yoavjavits/VoicceControl/RubiksCubeFirmware_Arduino_Mega/Readme.md

# Commands to send for robot using UART from ESP32
