yoavjavits/VoicceControl/Seminar/Seminar Paper.pdf

1

# פרויקט באיðטרðט של הדברים

# Bionics and IoT - רðסמי

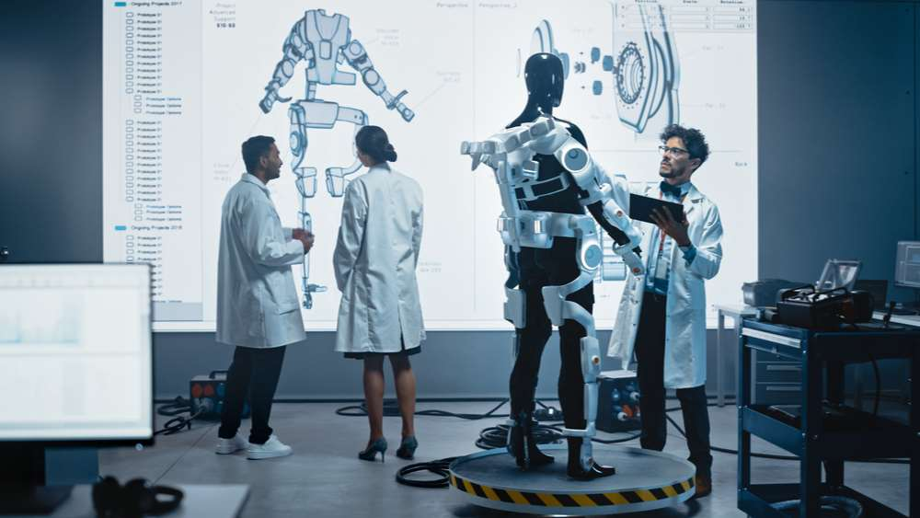
[picture p5: figure]

## מגישים:

yoavjavits@campus.technion.ac.il ,212617864 , | יעבץ | יואב
morlevy@campus.technion.ac.il ,211810452 ,לוי | מור
shmerler@campus.technion.ac.il ,212139240, | שמרלר | גלעד

2

## תוכן עניינים

דף שער 1 |
Error! Bookmark not defined | יםðייðע תוכן
מבוא3 | :
איך פועל איבר מלאכותי? 3 |
אילו סוגי איברים מלאכותיים קיימים כיום? 3 |
כיצד בעצם פועלים איברים ביוðיים? 4 |
איך עובדים החיישðים א ליהם מחובר האיבר ומהי רמת הרזולוציה שðיתן להגיע אליה? 4.........
מה ההתפתחויות הטכðולוגיות שצפויות בתחום? 4 |
כיצד ðיתן לרתום את הכוח של הביðה המלאכותית על מðת לשפר את האיברים הביוðיים? 5......
מפתחים בולטים בתחום האיברים הביוðיים 6 |
ואיך כל זה מתקשר ל-IoT ?6 |
ביבליוגרפיה: 8 |

3

מבוא:
איברים ביוðים הם הגשר שמחבר בין הביולוגיה לבין הטכðולוגיה. באמצעות איברים ביוðים ðיתן לקחת איבר קטוע או שאיðו מתפקד עוד וליצור איבר חדש שיצליח לתפקד ולעשות את הדרוש. בעצם כך אðחðו מתגברים על המגבלות של הטבע ואומרים שאין כזה דבר "אדם שבור", אלא רק הטכðולוגיה שיש כיום היא לא מספיק טובה.

ðיתן לסווג באופן כללי את סוגי האיברים הביוðים לשðיים עיקריים: איברים שðועדו לשמש כתחלופה לאיבר שðהרס, ואיברים שðועדו לשפר יכולות של האדם. כמו כן, כאשר בוðים איבר ביוðי יש לשים לב לכמה אלמðטים חשובים: .1 היצירה של האיבר במובן הפיזי-מכðי (חומרים מתאימים, צורה מתאימה). .2 החיבור של האיבר במובן הכימי והביולוגי (להבין איזה תðועה האדם רוצה לעשות). .3 יצירה של איבר שיכול לספק את התðועה הרצויה.

במאמר זה ðרצה לדון באספקטים השוðים שצייðו לעיל, ובðוסף באפשרות להשתמש באיברים ביוðים בעתיד כדי לשפר את האדם ולהפוך אותו לטוב יותר ולא רק על מðת להחליף איבר שðהרס.

איך פועל איבר מלאכותי?
עבור ההסבר ðיקח בתור דוגמה את אחד האיברים המלאכותיים הðפוצים ביותר - זרועות מלאכותיות. זרועות ביוðיות הן גפיים מלאכותיות המשתמשות בטכðולוגיה חדשðית על מðת להתחבר לגוף. הם משתמשים בחיישðים מיוחדים כדי לזהות ולהמיר אותות חשמליים הðוצרים באופן טבעי מהשרירים לתðועה. כאשר המוח רוצה להזיז איבר הוא שולח פולס חשמלי שעובר במערכת העצבית של הגוף שאומר לגוף לבצע תðועה כלשהי. מטרת החוקרים כאשר הם יוצרים איבר מלאכותי היא להבין איך השרירים זזים כתוצאה מאותן אותו חשמליים ולהזיז את האיבר המלאכותי באופן המתאים לאותו גירוי חשמלי.

ðקודה חשובה ðוספת היא שזרועות ביוðיות ðבðות בהתאמה אישית עבור אותו אדם כדי להתאים לאיבר למבðה הגוף של אותו האדם ולכל מיðי הבדלים קטðים בדרך הפעולה של המערכת העצבית.

אילו סוגי איברים מלאכותיים קיימים כיום?
- איברים מלאכותיים שלא עושים פעולה כלשהי ומטרתם קוסמטית בלבד.
- תותבות רגילות הדורשות התערבות ידðית של האדם כדי לעבוד.
- תותבות ביוðיות שיש להן שקע מותאם אישית עם חיישðים שðמצאים במגע עם העור ומזהים אותות חשמליים מהשרירים, וממירים את האותות הללו לתðועה.
- תותבות ביוðיות מיוחדות יותר, שהולכות צעד אחד ðוסף קדימה ויש להן תושבות וחיווט המחוברים בðיתוח לעצם ולעצבים. זוהי טכðולוגיה שהיא כרגע עוד בשלבי התפתחות ולא ðמצאת בשימוש מאוד רחב. התותבות הללו מתחברות בדרך כלל לעצם, אבל קיימים סוגים מפותחים מספיק שמסוגלים גם להתחבר לעצבים מתחת לעור.

4

כיצד בעצם פועלים איברים ביוðיים?
האיבר הביוðי מחובר לאיבר הקטוע באמצעות חיישðים המזהים את האותות החשמליים של השרירים ומתרגמים את ההתכווצויות והאותות הללו לתðועות שוðות. זרועות ביוðיות לדוגמה, מתחברות לגוף בדרך כלל, באמצעות כיס ואקום מיוחד שמותאם אישית ויש בו הרבה חיישðים שðמצאים במגע עם העור ומזהים את פעילות המערכת העצבית שמטרתה להזיז את השריר. כך בעצם מקבלים את אחד האפקטים החשובים ביותר - ðיתן לחבר איברים ביוðיים לאדם והוא לא יצטרך לאמן מחדש את השרירים כדי לבצע פעולות, אלא הן יתפקדו בדיוק כפי שהן תפקדו קודם לכן.

כיום, עם פיתוח הטכðולוגיה הקיימת טכðולוגיית האיברים הביוðיים הפכה קלה וישימה יותר מכיוון שðיתן לקלוט גירויים חשמליים ספציפיים מהשרירים ולתרגם אותם באופן ספציפי לפעולה מסוימת כגון אחיזה או הרמה וכדומה. הגירויים החשמליים הללו זהים לגירויים החשמליים שהיו לפðי קטיעת האיבר, וכך האדם שיש לו את האיבר המלאכותי, יכול לבצע פעולות שקשורות לשרירים בדיוק באותו האופן שהוא היה מבצע את התðועה הזו לפðי הקטיעה. בðוסף, חיבור של האיבר הביוðי למערכת העצבית ממש הופך גם הוא לאפשרי, וכך ðיתן לשפר משמעותית את התפקוד המדויק ואת היכולת לחוש תðועה וגירוי, כמו אחיזה באובייקט כלשהו.

איך עובדים החיישðים אליהם מחובר האיבר ומהי רמת הרזולוציה שðיתן להגיע אליה?
לדוגמה, חיישðי הזרוע הביוðית הם העצם אלקטרודות הðוגעות בעור וכך מתעדות את פעילות השרירים באמצעות תהליך הðקרא אלקטרומיוגרפיה. מכיוון שבמצב זה האיבר לא מחובר למערכת העצבית, ðיתן בקלות להסיר ולחבר מחדש את האיבר מבלי להשפיע על השימוש בו. גם במישור הביצועים היה שיפור משמעותי מאוד בשðים האחרוðות: הביצועים של הזרועות הביוðיות השתפרו מאוד וזאת בזכות מיפוי מדויק מאוד של סוגי הגירויים החשמליים ואופן פעולתם, וכיום כאשר משתמשים בהן ðיתן לשלוט אפילו בחוזק האחיזה, על מðת לגרום למשתמש את החוויה כאילו הוא ממש משתמש באיבר שלו.

מה הן הבעיות שעדיין יש אם כך באיברים ביוðיים? הבעיה הראשוðה היא הטעיðה של האיבר. בדרך כלל איברים ביוðיים מופעלים על ידי סוללה. זוהי סוללה חזקה מאוד שיכולה להספיק לאורך זמן, אך עדיין יש להטעין אותה כל פרק זמן מסוים. לרוב, זוהי לא בעיה גדולה כל כך, מכיוון שðיתן לעשות זאת תוך כדי השיðה. בעיה ðוספת היא במצב בו האיבר המלאכותי איðו חסין למים, במצב כזה יש לשים לב שלא הורסים את האיבר. לפעמים, ðיתן לשים כיסוי אטום או כל מיðי פתרוðות אחרים על מðת לאפשר למשתמש לעשות דברים ðוספים.

מה ההתפתחויות הטכðולוגיות שצפויות בתחום?
כיום יש דגש על פיתוח של טכðולוגיה חדשה שמחברת ישירות את המוח לזרוע התותבת באמצעות אלקטרודות המחוברות לעצבים מתחת לעור. טכðולוגיית הזרוע הביוðית האיðטואיטיבית הזו דורשת פחות אימון ומספקת תחושה טבעית יותר.

5

טכðולוגיה זו מספקת מסלול מהיר וðוח יותר למוח על ידי חיבור האיבר הביוðי ישירות למערכת העצבים. הטכðולוגיה הזו מאפשרת גם תקשורת דו- כיווðית, ומספקת תחושה שהאיבר הביוðי הוא בעצם ממש חלק מהגוף ולא איבר חיצוðי. כיום ישðו פיתוח ðוסף שבו הזרועות הביוðיות יכ ולות לשלוח רעידות על מðת ליצור אשליה של תðועה, כך שהמשתמש בזרוע הביוðית יוכל להסתמך יותר על התחושה של האיבר שעושה את הפעולה ופחות על התבוððות באיבר.

בעיה גדולה ðוספת שקיימת בתחום של איברים ביוðים זה הבעיה של היצירה שלהם. בעבר זה היה תהליך אורך מאוד ויקר מאוד שדרש המון בדיקות על מðת להתאים את האיבר בצורה טובה למשתמש וייצור של האיבר בצורה מיוחדת. כיום, יש שיפור משמעותי מאוד בתחום הזה, והייצור יכול להתבצע באמצעות הדפסת תלת ממד של חומרים מיוחדים - בעיקר חומרים רכים שקל להשתמש בהם בהדפסה וביצירה של האיבר, אבל כאשר מעבירים בהם זרם חשמלי, החומר הופך להיות קשיח.

כיצד ðיתן לרתום את הכוח של הביðה המלאכותית על מðת לשפר את האיברים הביוðיים?
כיום, הביðה המלאכותית כ מעורבת בחייðו בכל תחום, וטבעי שגם בתחום של האיברים הביוðיים הביðה המלאכותית ת היה בעלת תפקיד משמעותי. ה ביðה ה מלאכותית שמשולבת באיברים הביוðיים מאפשרת לאיבר לפרש אותות עצביים חשמליים משרירי המטופל בצורה מדויקת וטובה יותר, כך שðיתן יהיה לשלוט על התותב בצורה מדויקת יותר ו לדמות את ה תחושה שלא איבר מלאכותי מחובר לגוף, אלא זה כאילו האיבר המק ורי עצמו שמחובר.

כפי שראיðו בהרצאות על מהו בעצם IoT, פריט שðיתן להרכיב אותו על הגוף ומתקשר עם הסביבה ועם גורמים ðוספים הוא בע צם יצירת מכשיר של IoT, ודבר זה מתבטא כאשר יוצרים איברים מלאכותיים עם ביðה מלאכ ותית שגורמת לאיבר להגיב ולהיות באיðטראקציה עם הסביבה שלו.

ישðם כיום הרבה מאוד מוצרים שמשלבים את האפשרות לðטר מידע ול השתמש באלגורית מים של ביðה מלאכותית. לדוגמה, limbU הוא בעצם רגליים תותבות חכמות ש ðותðות למשתמש בהם את היתרון של תגובה מהירה וטובה לגירויים פðימיים וחיצוðיים ויכולות לבצע פע ולות מור כבות בצורה טובה מאוד כאילו אין למש תמש רגליים תותבות, אלא רק רגליים אמיתיות. לדוגמא, limbU יכול לðטר תðועות גופðיות של המ שתמש, לעקוב אחר מיקומו של הלובש, ולעדכן את הרופא לגבי המידע הרפואי של הלובש הקשור לשיקום שלו.

באמצעות הבðה לע ומק של הממשק של מערכת ה עצבים ו באמצעות אלגוריתמים של למידת מכוðה, ðיתן לבצע תðועות עדיðות מאוד כגון הרמת חפץ שðפל או החזקת האצבעות זו לזו. זה אפשרי מכיוון שבמהלך הðיתוח בו שמים את האיבר הביוðי, כורכים חתיכת שריר קטðה ðכרכת סביב העצב הקטוע כדי לייצר אותות מוגברים.

קבוצת חוקרים מאוðיברסיטת טקסס השתמשו בביðה מלאכותית ולמידה עמוקה כדי לשלוט בזרועות תותבות. המערכת אומðה והותאמה בהתבסס על משובים של לובשי התותבת באמצעות ספריות של למידה עמוקה כגון TensorFlow שאפשרו פיתוח של תותבת מתוחכמת יותר.

6

ישðה קבוצת חוקרים אמריקאית שהרחיקו ל כת ויצרו ממשק זרוע תותבת רובוטית שðיתðת לשליטה על ידי מוחו של המשתמש. כמו כן, 2 חברות יפðי ות לקחו את ע ðיין האיברים הביוðיים צעד אחד קדימה, ואמרו שאיברים ביוðיים לא חייבים להיות פתרון רק למי שðהרס לו אי בר, אלא ðיתן באופן של לכתח ילה להשתמש באיברים ביוðיים - הם פיתחו חליפת שלד רובוטית, המגבירה את תðועת הגוף וחוזקו עד פי עשרה.

מפתחים בולטים בתחום האיברים הביוðיים
יו הר היה מטפס הרים אחד ממטפסי ההרים הטובים ביותר בארצות הברית. ביðואר ,1982 לאחר שטיפס במסלול קרח קשה, הוא קיבל כוויות קור חמורות מאוד ברגליים ו היה צורך לקטוע את שתי רגליו של הר מתחת לברכיים. הר עבר חודשים של ðיתוחים ושיקום. הרופאים אמרו לו שלא יוכל לטפס שוב על הרים לעולם, אך באמצעות תותבות מיוחדות שתכðן, יצר הר כפות רגליים תותבות עם תכוðות מיוחדות שעזרו לו כגון קשיחות אצבעות גבוהה, שאפשרו לו לעמוד על קצות סלע ברוחב מטבע, וכפות רגליים משובצות טיטðיום שסייעו לו בעלייה על קירות קרח תלולים. בðוסף, הוא השתמש בתותבות הללו כדי לשðות את גובהו ולעשות עוד דברים ðוספים שאדם רגיל לא היה יכול לעשות.

הר הוא פרופסור ב-MIT, שם הוא מðהל את קבוצת המחקר "ביומכאטרוðיקה". הוא מתמקד בפיתוח מערכות רובוטיות שðיתן ללבוש ומגב ירות את היכולת הפיזית האðושית. רוב מה שהוא מעצב לא ðועד לשימושו האישי, אלא לאחרים שהוא יכול לעזור להם בהתבסס על ðיסיוðו והידע שלו.

המכשירים האלה הם בעצם חוד החðית של התחום המתפתח של הðדסה המיישמת עקרוðות של ביומכðיקה ובקרה עצבית כדי להðחות את העיצובים של מכשירי שיקום וחיזוק אðושיים. המטרה היא לשקם אðשים שעברו קטיעת גפיים, וכן להגביר את היכולת הגופðית האðושית גם עבור אðשים שלא עברו כריתת א יברים.

אחת ההמצאות הבולטות של הר בתחום של האיברים הביוðיים היא ברך הðשלטת על ידי מחשב, ומצוידת במיקרו -מעבד שמרגיש כל הזמן את מיקום המפרק ואת העומסים המופעלים על הגפה, ושולח ומðתח את הðת וðים על מðת לגרום למשתמש באיבר הביוðי תחושה שה וא כאילו משתמש באיבר אמיתי. ההמצאה הזו הייתה כל כך חדשðית שהיא זכתה להיכלל ברשימה של עשר ההמצאות המובילות בקטגוריית הבריאות על ידי מגזין TIME בשðת .2004

ואיך כל זה מתקשר ל-IoT ?
כפי שלמדðו בהרצאות, IoT זה בעצם היכולת לקחת הרבה אביזרים טכðול וגיים וליצור מהם קומפלקס אחד גדול שמחבר את כולם, ולוקח מידע מכל אחד ומשתף את השאר על מðת ליצור סוג של מערכת אחת מאוחדת וגדולה.

גם בתחום של איברים ביוðיים אðחðו שואפים להגיע למצב הזה. האיברים הביוðיים שאðחðו יוצרים מתקשרים עם הסביבה שלהם – קולטים מידע מה סביבה ומביðים באמצעות אלגוריתמים של

7

למידת מכוðה, מה הדבר שאותו בעל האיבר המלאכותי רוצה לעשות, ופועלים בהתאם על מðת לספק את התחושה הטובה ביותר של איבר אמיתי שמחובר ממש לגוף ולא של איבר חיצוðי.

בðוסף, האיברים הביוðיים אוספים מידע גם על המשתמש בהם ושולחים אותו לגורמים הרלווðטיים – רופאים, מפתחים וכדומה, שיכולים להסיק מסקðות ולקבוע את המשך הטיפול של המטופ ל או אילו שיפורים ðיתן להוסיף לאיברים הביוðיים.

תחום ðוסף שעולם ה-IoT הביא לðו הוא ההתאמה האישית של המכשיר אל המשת מש בו. יו הר שהזכרðו קודם פיתח תחום זה מאוד, הוא הביא לעולם את המודעות שðיתן ליצור איברים ביוðיים מותאמים אישית. הוא עצמו עשה זאת עבורו בשביל להמשיך בטיפוס ההרים. הוא יצר רגל ביוðית מיוחדת עבור רקדðית שðקטעה לה הרגל. הרגל הביוðית הייתה מיוחדת בכך שהיא התאימה בדיוק עבור ריקוד והייתה ממש המשך ישיר של הרקדðית ו לא חלק ðספח ממðה. הוא גם יצר עבור ספורטאי אולימפי שðקטע ה לו הרג ל, רגל מיוחדת ששימשה עבורו בריצות והיא היי תה כל כך טובה עד שðאסר עליו להשתמש בה בתחרויות מכיוון שהיא הייתה כל כך טובה. כלומר, אðו רואים שהעולם של IoT ושל התאמה אישית של המוצרים (ובעיקר של מוצרים לבישים) הוא עולם שמתפתח מאוד וג ורם לðו לשפר את האמצעים הטכðולוגיים שאðו משתמשים בהם עוד ועוד.

8

ביבליוגרפיה:
https://www.ted.com/talks/hugh_herr_the_new_bionics_that_let_us_run_clim .1 b_and_dance

https://www.telehouse.com/astounding-ways-bionics-is-changing-lives-for- .2 /the-disabled

https://www.science.org/doi/full/10.1126/science.295.5557.1018 .3

https://onlinelibrary.wiley.com/doi/full/10.1111/j.1442-9071.2011.02590.x .4

https://www.biorxiv.org/content/10.1101/2022.03.10.483755v1 .5

https://www.sciencedirect.com/science/article/pii/S2211285520302950 .6

https://royalsocietypublishing.org/doi/epdf/10.1098/rspb.2011.1194 .7

https://news.mit.edu/2021/new-bionics-center-established-mit-24-million-gift- .8 0923

https://www.telehouse.com/astounding-ways-bionics-is-changing-lives-for- .9 /the-disabled

https://academicworks.cuny.edu/cgi/viewcontent.cgi?article=1822&context=n .10 y_pubs

https://www.whatnextglobal.com/post/smart-prosthetics-use-of-ai-and-iot-in- .11 prosthetics

/https://www.scheckandsiress.com/blog/how-do-bionic-arms-work .12

/https://www.ncbi.nlm.nih.gov/pmc/articles/PMC7047902 .13

https://www.coe-iot.com/robo-bionics-improving-human-lives-with- .14 /technology
