yoavjavits/VoicceControl/Process_VoiceControl/Hardware/Design/Qbot/F87MJRMJT4TMZTT.brd

## EAGLE design Process_VoiceControl/Hardware/Design/Qbot/F87MJRMJT4TMZTT.brd (2022-07-25, last stored version)

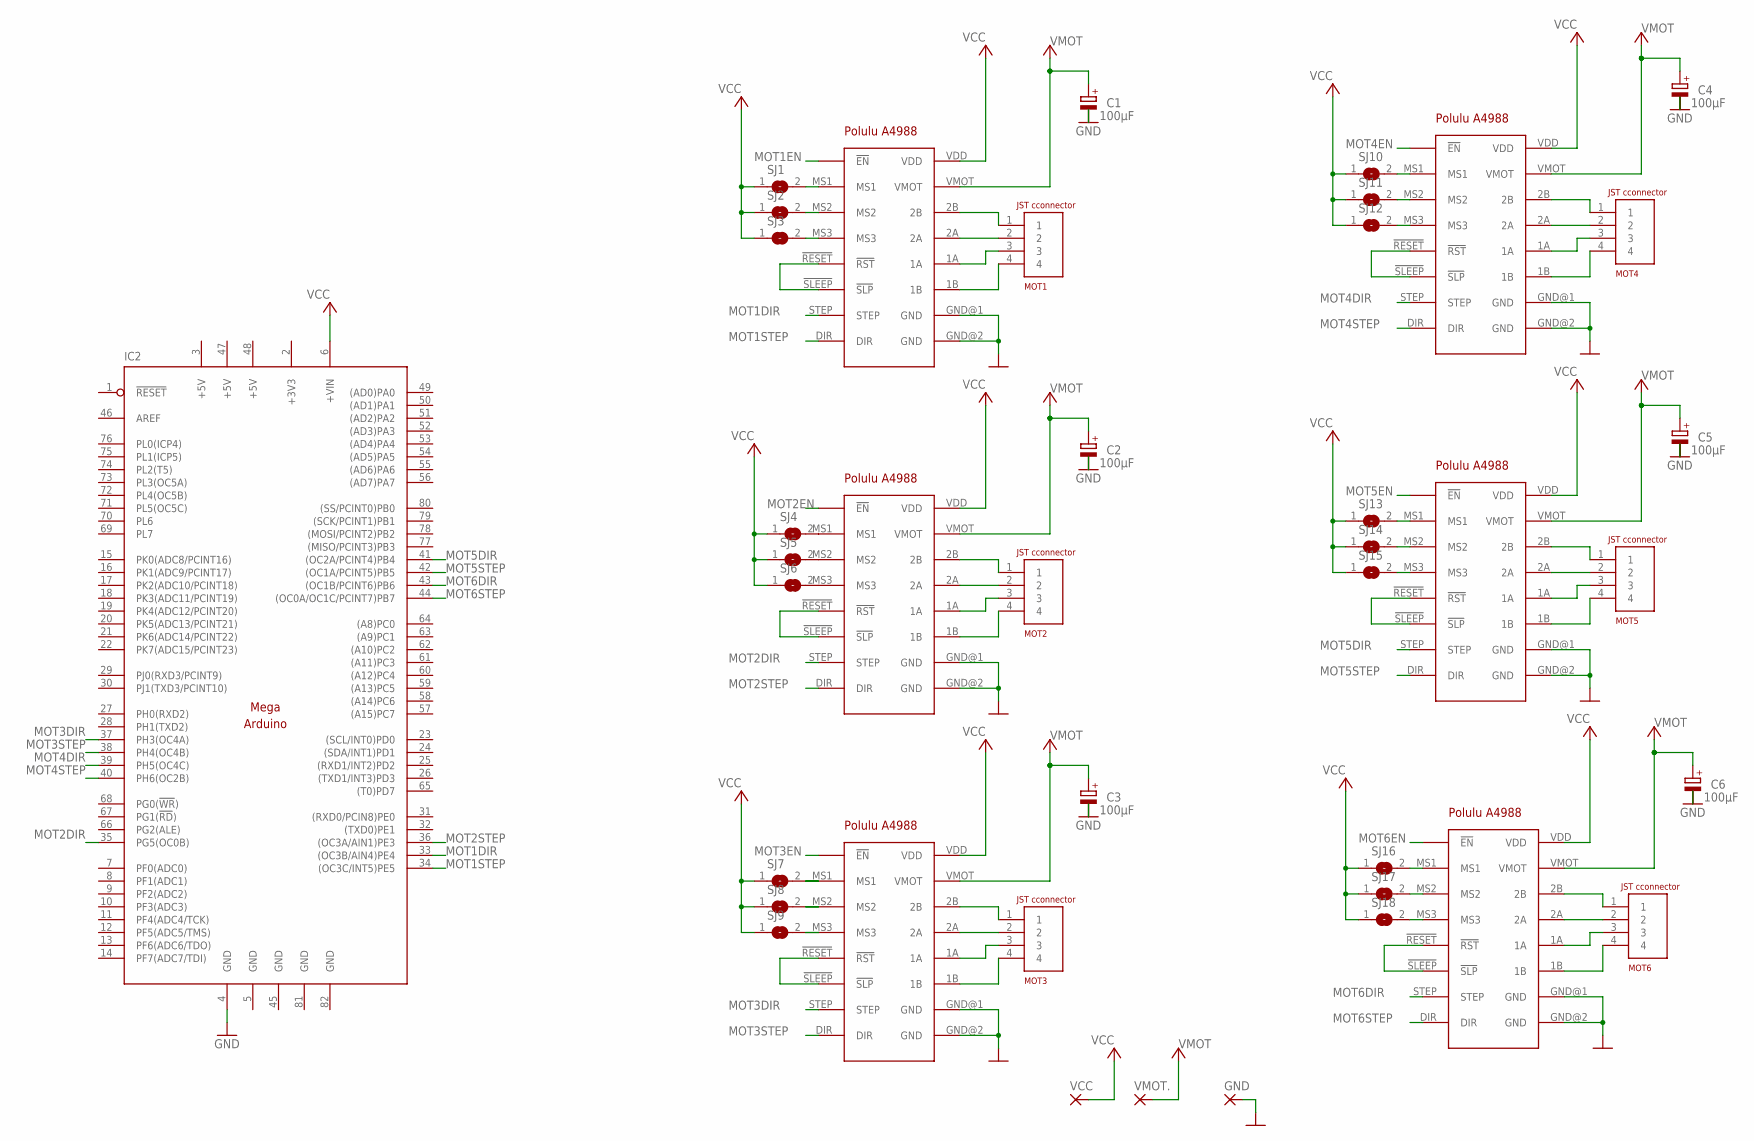
[picture p6: schematic FU92G6PJT4TMZTU.sch]

Parts:
C1, C2, C3, C4, C5, C6: 100µF; TT2D7
GND: 3,17/1,3
IC2: MEGAARDUINO_11; MEGA_ARDUINO_1
M1, M2, M3, M4, M5, M6: POLULUA4988CORRECT; POLULU_A4988
MOT1, MOT2, MOT3, MOT4, MOT5, MOT6: 4PIN_JST
SJ1, SJ2, SJ3, SJ4, SJ5, SJ6, SJ7, SJ8, SJ9, SJ10, SJ11, SJ12, SJ13, SJ14, SJ15, SJ16, SJ17, SJ18: SJW
VCC: 3,17/1,3
VMOT.: 3,17/1,3

Connections:
+3V3: IC2.2 (+3V3)
+5V: IC2.3 (+5V), IC2.47 (+5V), IC2.48 (+5V)
GND: C1.-, C2.-, C3.-, C4.-, C5.-, C6.-, GND.1, IC2.4 (GND), IC2.5 (GND), IC2.45 (GND), IC2.81 (GND), IC2.82 (GND), M1.GND@1 (GND), M1.GND@2 (GND), M2.GND@1 (GND), M2.GND@2 (GND), M3.GND@1 (GND), M3.GND@2 (GND), M4.GND@1 (GND), M4.GND@2 (GND), M5.GND@1 (GND), M5.GND@2 (GND), M6.GND@1 (GND), M6.GND@2 (GND)
MOT1DIR: IC2.33 ((OC3B/AIN4)PE4), M1.STEP
MOT1EN: M1.!EN
MOT1STEP: IC2.34 ((OC3C/INT5)PE5), M1.DIR
MOT2DIR: IC2.35 (PG5(OC0B)), M2.STEP
MOT2EN: M2.!EN
MOT2STEP: IC2.36 ((OC3A/AIN1)PE3), M2.DIR
MOT3DIR: IC2.37 (PH3(OC4A)), M3.STEP
MOT3EN: M3.!EN
MOT3STEP: IC2.38 (PH4(OC4B)), M3.DIR
MOT4DIR: IC2.39 (PH5(OC4C)), M4.STEP
MOT4EN: M4.!EN
MOT4STEP: IC2.40 (PH6(OC2B)), M4.DIR
MOT5DIR: IC2.41 ((OC2A/PCINT4)PB4), M5.STEP
MOT5EN: M5.!EN
MOT5STEP: IC2.42 ((OC1A/PCINT5)PB5), M5.DIR
MOT6DIR: IC2.43 ((OC1B/PCINT6)PB6), M6.STEP
MOT6EN: M6.!EN
MOT6STEP: IC2.44 ((OC0A/OC1C/PCINT7)PB7), M6.DIR
unnamed: M1.MS1, SJ1.2
unnamed: M1.MS2, SJ2.2
unnamed: M1.MS3, SJ3.2
unnamed: M1.2B, MOT1.1
unnamed: M1.2A, MOT1.2
unnamed: M1.1A, MOT1.3
unnamed: M1.1B, MOT1.4
unnamed: M2.MS1, SJ4.2
unnamed: M2.MS2, SJ5.2
unnamed: M2.MS3, SJ6.2
unnamed: M2.2B, MOT2.1
unnamed: M2.2A, MOT2.2
unnamed: M2.1A, MOT2.3
unnamed: M2.1B, MOT2.4
unnamed: M2.!RESET (!RST), M2.!SLEEP (!SLP)
unnamed: M3.2B, MOT3.1
unnamed: M3.2A, MOT3.2
unnamed: M3.1A, MOT3.3
unnamed: M3.1B, MOT3.4
unnamed: M3.!RESET (!RST), M3.!SLEEP (!SLP)
unnamed: M4.2B, MOT4.1
unnamed: M4.2A, MOT4.2
unnamed: M4.1A, MOT4.3
unnamed: M4.1B, MOT4.4
unnamed: M4.!RESET (!RST), M4.!SLEEP (!SLP)
unnamed: M4.MS1, SJ10.2
unnamed: M4.MS2, SJ11.2
unnamed: M4.MS3, SJ12.2
unnamed: M5.2B, MOT5.1
unnamed: M5.2A, MOT5.2
unnamed: M5.1A, MOT5.3
unnamed: M5.1B, MOT5.4
unnamed: M5.!RESET (!RST), M5.!SLEEP (!SLP)
unnamed: M5.MS1, SJ13.2
unnamed: M5.MS2, SJ14.2
unnamed: M5.MS3, SJ15.2
unnamed: M6.2B, MOT6.1
unnamed: M6.2A, MOT6.2
unnamed: M6.1A, MOT6.3
unnamed: M6.1B, MOT6.4
unnamed: M6.!RESET (!RST), M6.!SLEEP (!SLP)
unnamed: M6.MS1, SJ16.2
unnamed: M6.MS2, SJ17.2
unnamed: M6.MS3, SJ18.2
unnamed: M1.!RESET (!RST), M1.!SLEEP (!SLP)
VCC: IC2.6 (+VIN), M1.VDD, M2.VDD, M3.VDD, M4.VDD, M5.VDD, M6.VDD, SJ1.1, SJ2.1, SJ3.1, SJ4.1, SJ5.1, SJ6.1, SJ7.1, SJ8.1, SJ9.1, SJ10.1, SJ11.1, SJ12.1, SJ13.1, SJ14.1, SJ15.1, SJ16.1, SJ17.1, SJ18.1, VCC.1
VMOT: C1.+, C2.+, C3.+, C4.+, C5.+, C6.+, M1.VMOT, M2.VMOT, M3.VMOT, M4.VMOT, M5.VMOT, M6.VMOT, VMOT..1

Board: 2 copper layers, 40 parts (0 on the bottom side), 61 nets, no tracks yet.
