yoavjavits/VoicceControl/SplitNetwork_ESP32/src/CommandDetector.cpp

#include <Arduino.h>
#include "I2SSampler.h"
#include "AudioProcessorWakeWord.h"
#include "AudioProcessorCommand_FLU.h"
#include "AudioProcessorCommand_BRU.h"
#include "../lib/neural_network_command_FLU/src/NeuralNetworkCommand_FLU.h"
#include "../lib/neural_network_command_BRU/src/NeuralNetworkCommand_BRU.h"
#include "../lib/neural_network_wake_word/src/NeuralNetworkWakeWord.h"
#include "RingBuffer.h"
#include "CommandDetector.h"
#include "CommandProcessor.h"

#define WINDOW_SIZE 320
#define STEP_SIZE 160
#define POOLING_SIZE 6
#define AUDIO_LENGTH 16000
#define DETECTION_THRESHOLD -3
#define WAIT_PERIOD 1500

CommandDetector::CommandDetector(I2SSampler *sample_provider)
{
    // save the sample provider for use later
    m_sample_provider = sample_provider;
    m_last_detection = 0;

    isWakeWord = true;
    first_time = true;
}

CommandDetector::~CommandDetector()
{
}

void CommandDetector::run()
{
    if (isWakeWord)
    {
        if (first_time)
        {
            /* Create for WakeWord */
            m_nn_wake_word = new NeuralNetworkWakeWord();
            // Serial.println("Created Neural Network Wake Word");
            //  create our audio processor
            m_audio_processor_wake_word = new AudioProcessorWakeWord(AUDIO_LENGTH, WINDOW_SIZE, STEP_SIZE, POOLING_SIZE);
            first_time = false;
        }

        // time how long this takes for stats
        long start = millis();

        // get access to the samples that have been read in
        RingBufferAccessor *reader = m_sample_provider->getRingBufferReader();

        // rewind by 1 second
        reader->rewind(16000);

        // get hold of the input buffer for the neural network so we can feed it data
        float *input_buffer = m_nn_wake_word->getInputBufferWakeWord();

        // process the samples to get the spectrogram
        m_audio_processor_wake_word->get_spectrogramWakeWord(reader, input_buffer);

        // finished with the sample reader
        delete reader;

        // get the prediction for the spectrogram
        float output = m_nn_wake_word->predictWakeWord();
        long end = millis();

        // use quite a high threshold to prevent false positives
        if (output > 0.95 && start - m_last_detection > WAIT_PERIOD)
        {
            m_last_detection = start;
            Serial.printf("P(%.2f): Detect the word go\n", output);

            digitalWrite(GPIO_NUM_2, HIGH);
            delay(500);

            isWakeWord = false;
            first_time = true;
            tone(18, 2000); // turn buzzer on
            delay(500);

            digitalWrite(GPIO_NUM_2, LOW);
            pinMode(18, INPUT);

            delete m_nn_wake_word;
            m_nn_wake_word = NULL;
            delete m_audio_processor_wake_word;
            m_audio_processor_wake_word = NULL;
            // Serial.println("destroyed Neural Network Wake Word");
        }
    }

    else
    {
        if (first_time)
        {
            m_nn_command_FLU = new NeuralNetworkCommand_FLU();
            m_nn_command_BRU = new NeuralNetworkCommand_BRU();

            m_audio_processor_command_FLU = new AudioProcessorCommand_FLU(AUDIO_LENGTH, WINDOW_SIZE, STEP_SIZE, POOLING_SIZE);
            m_audio_processor_command_BRU = new AudioProcessorCommand_BRU(AUDIO_LENGTH, WINDOW_SIZE, STEP_SIZE, POOLING_SIZE);

            Serial.println("Created Neural Network Command");
            first_time = false;
        }

        // time how long this takes for stats
        long start = millis();

        // get access to the samples that have been read in
        RingBufferAccessor *reader = m_sample_provider->getRingBufferReader();
        RingBufferAccessor *reader2 = m_sample_provider->getRingBufferReader();

        // rewind by 1 second
        reader->rewind(16000);

        // get hold of the input buffer for the neural network so we can feed it data
        float *input_buffer_FLU = m_nn_command_FLU->getInputBufferCommand_FLU();
        float *input_buffer_BRU = m_nn_command_BRU->getInputBufferCommand_BRU();

        // process the samples to get the spectrogram
        RingBufferAccessor::make_same(reader, reader2);

        bool is_valid_FLU = m_audio_processor_command_FLU->get_spectrogramCommand_FLU(reader, input_buffer_FLU);
        bool is_valid_BRU = m_audio_processor_command_BRU->get_spectrogramCommand_BRU(reader2, input_buffer_BRU);

        // finished with the sample reader
        delete reader;
        delete reader2;

        // get the prediction for the spectrogram
        NNResult_FLU result_FLU = m_nn_command_FLU->predictCommand_FLU();
        NNResult_BRU result_BRU = m_nn_command_BRU->predictCommand_BRU();

        float best_score_FLU = result_FLU.score;
        int best_index_FLU = result_FLU.index;
        float best_score_BRU = result_BRU.score;
        int best_index_BRU = result_BRU.index;

        long end = millis();
        char move = 'i';

        bool check = best_score_FLU > best_score_BRU;
        float best_score = check ? best_score_FLU : best_score_BRU;
        int best_index = check ? best_index_FLU : best_index_BRU;

        // sanity check best score and check the cool down period
        if (best_score > 0.95 && best_index != NUMBER_COMMANDS - 1 && start - m_last_detection > WAIT_PERIOD)
        {
            m_last_detection = start;

            if (check)
            {
                switch (best_index)
                {
                case 0:
                    Serial.printf("P(%.2f): Detect the word %s\n", best_score, "forward");
                    move = 'f';
                    break;

                case 1:
                    Serial.printf("P(%.2f): Detect the word %s\n", best_score, "up");
                    move = 'u';
                    break;

                case 2:
                    Serial.printf("P(%.2f): Detect the word %s\n", best_score, "left");
                    move = 'l';
                    break;

                default:
                    break;
                }
            }
            else
            {
                switch (best_index)
                {
                case 0:
                    Serial.printf("P(%.2f): Detect the word %s\n", best_score, "backward");
                    move = 'b';
                    break;

                case 1:
                    Serial.printf("P(%.2f): Detect the word %s\n", best_score, "right");
                    move = 'r';
                    break;

                case 2:
                    Serial.printf("P(%.2f): Detect the word %s\n", best_score, "down");
                    move = 'd';
                    break;

                default:
                    break;
                }
            }

            digitalWrite(GPIO_NUM_2, HIGH);
            isWakeWord = true;
            first_time = true;
            delay(250);
            digitalWrite(GPIO_NUM_2, LOW);

            delete m_nn_command_FLU;
            m_nn_command_FLU = NULL;
            delete m_audio_processor_command_FLU;
            m_audio_processor_command_FLU = NULL;

            delete m_nn_command_BRU;
            m_nn_command_BRU = NULL;
            delete m_audio_processor_command_BRU;
            m_audio_processor_command_BRU = NULL;

            // Serial.println("destroyed Neural Network Command");

            process_command(move);
        }
    }
}
